samuroo/flashbot/schematic.png

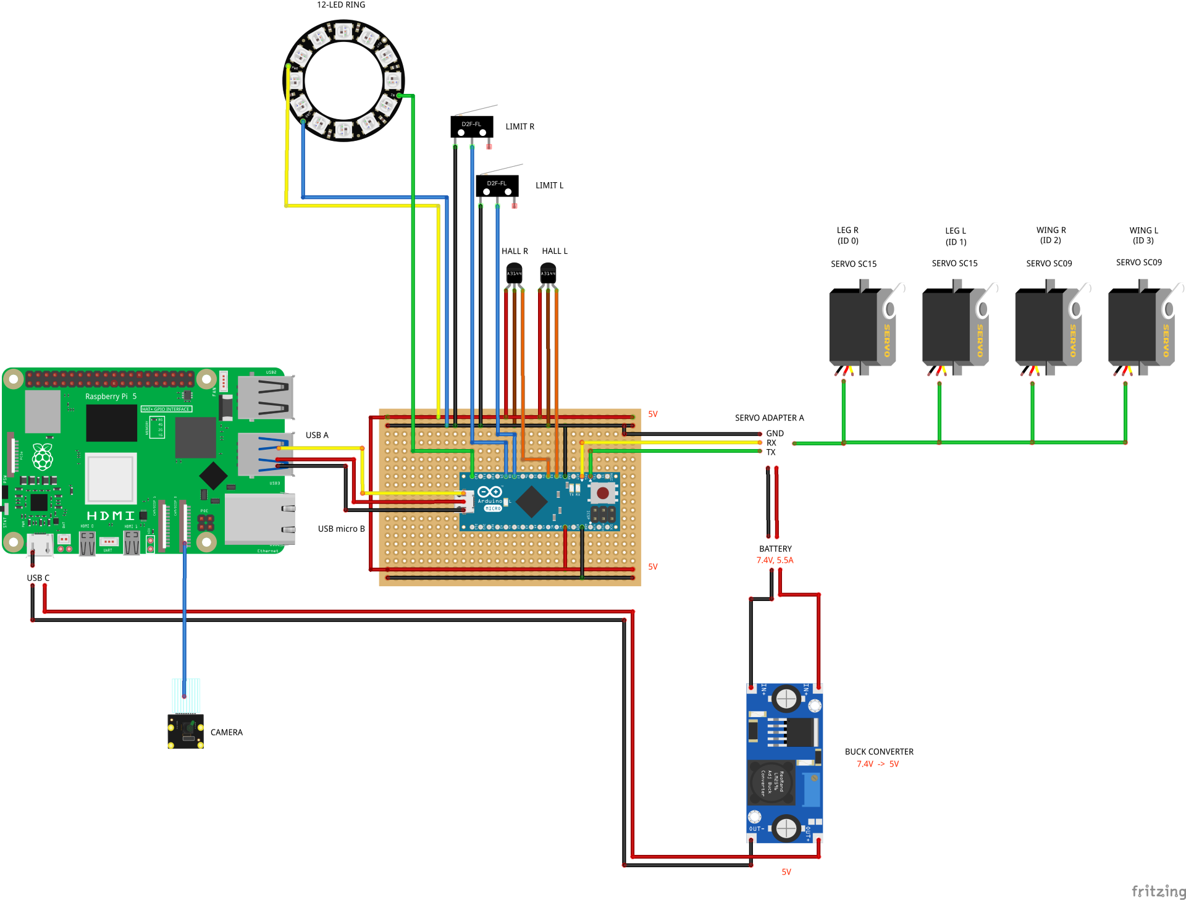
schematic.png
