samuroo/flashbot/(commit log)

2026-01-11 adding detection and serial communcation files
    [yolo-fastest-1.1.cfg]
2026-02-03 adding updates for new led NeoPixel and servo wings. both are implmented in FSM, need testing on actual flashbot)
2026-02-08 added hall effect sensor sync
2026-02-09 adding 180 degree rotated config. pi camera
2026-03-24 adding camera test
2026-03-29 adding code for computer-camera, pi-camera, and pi
2026-03-29 truing frame differnt
2026-03-29 reducing size of actual frame for web
2026-04-07 changed 5 to 30 for jpeg quality and moved the frame update line in main when arudino is connected
2026-05-04 adding updated webpage and frame update confintiously
2026-05-23 removing old main script and detection for the ros2 development
    [yolo-fastest-1.1.cfg]
2026-06-15 Add full ROS 2 bring-up and behavior test flow
2026-06-15 adding servo updates
2026-07-14 adding updated print statement for when face detected and added speed up timer
2026-07-17 flipped camera stream
